Omar-Amaraa/Solar-Irradiance-Thermal-Sensor/data/plots/tensions_vs_temps.png

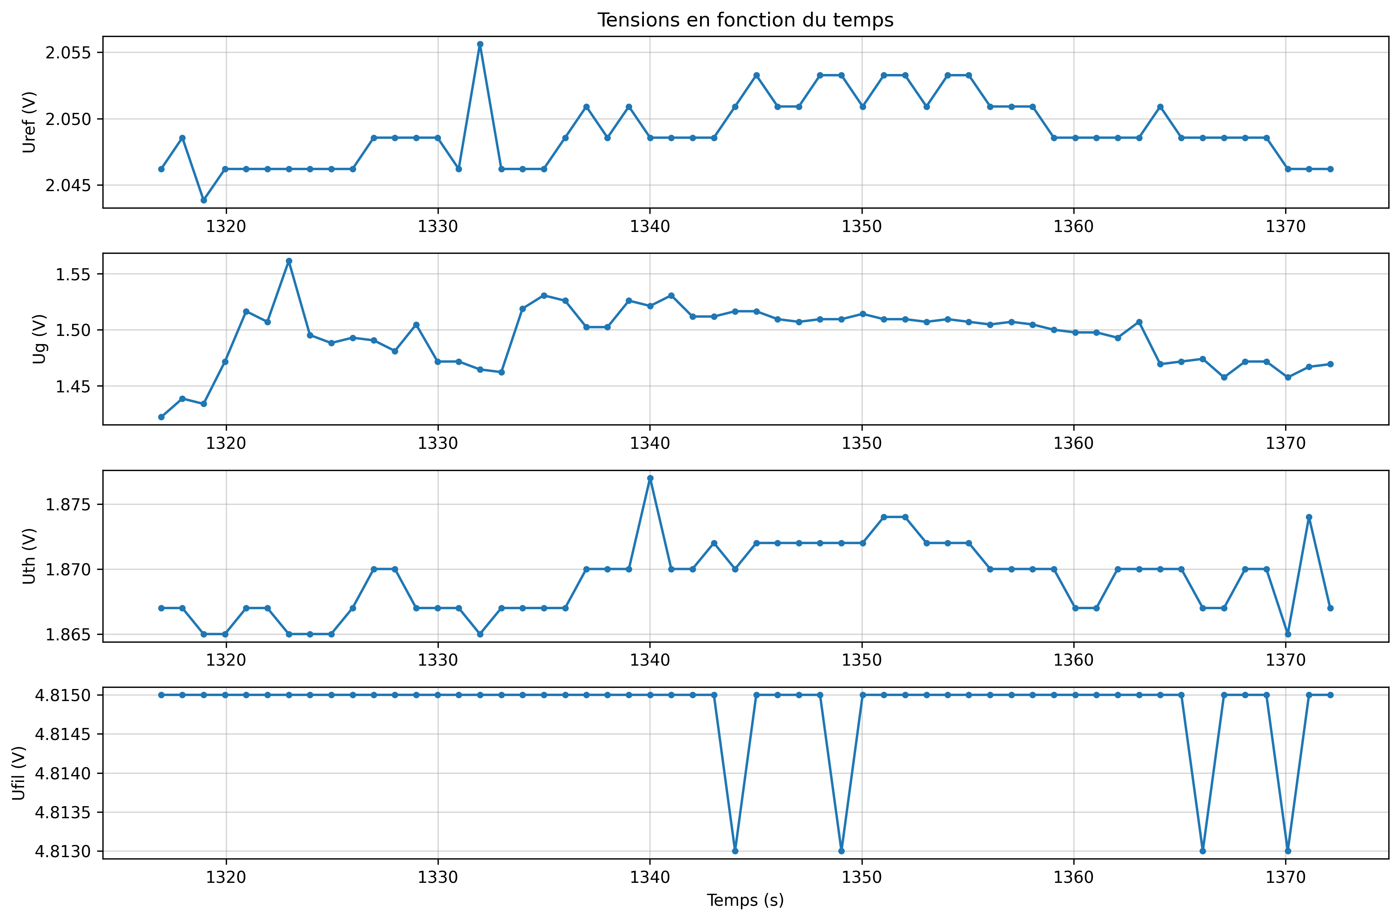
data/plots/tensions_vs_temps.png
