Omar-Amaraa/Solar-Irradiance-Thermal-Sensor/data/plots/Ug_vs_Uref_gain.png

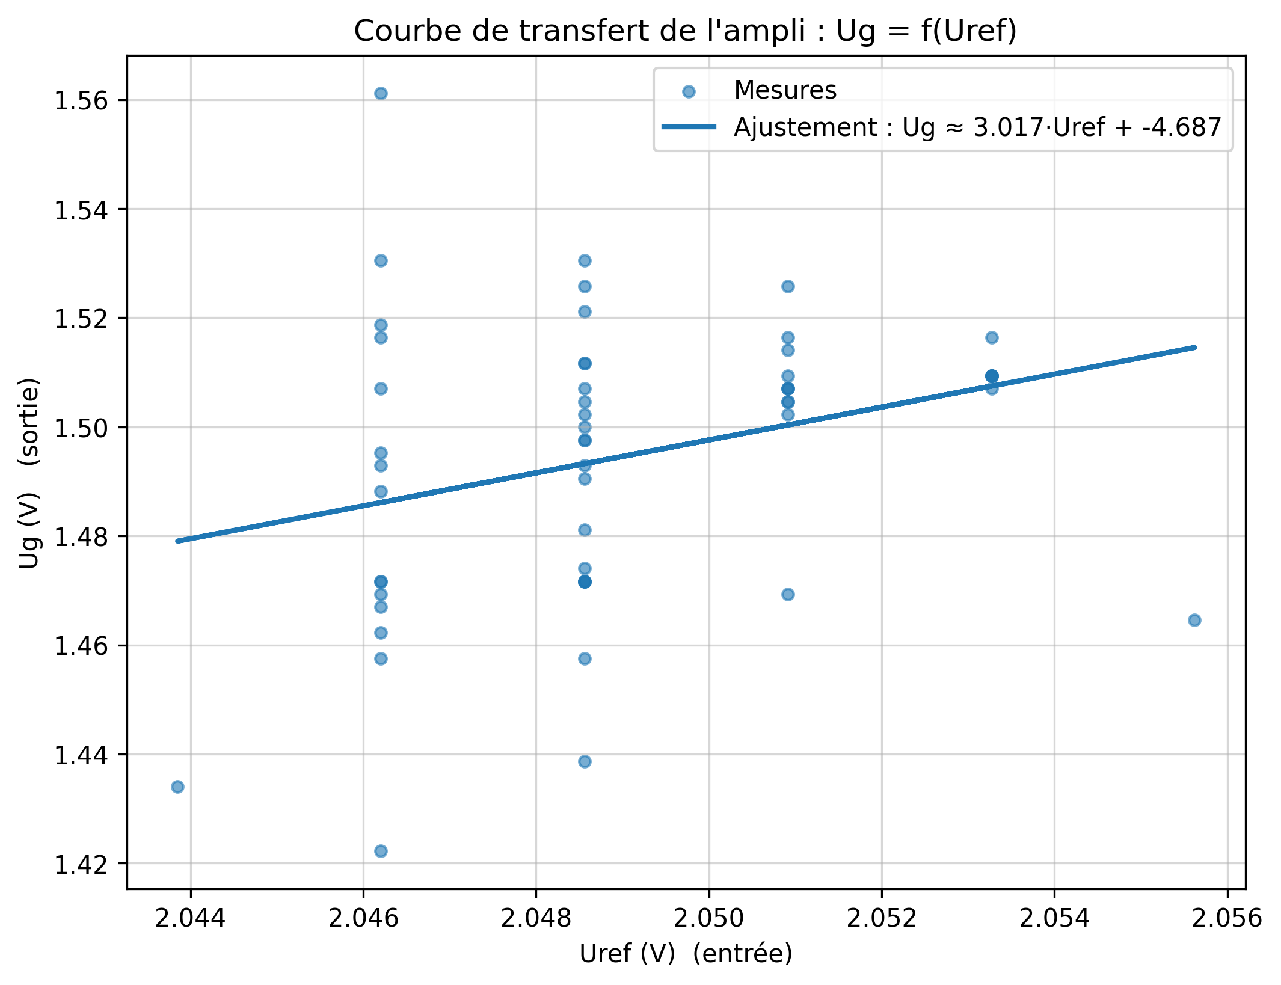
data/plots/Ug_vs_Uref_gain.png
