Omar-Amaraa/Solar-Irradiance-Thermal-Sensor/data/plots/Uth_Ufil_vs_temps.png

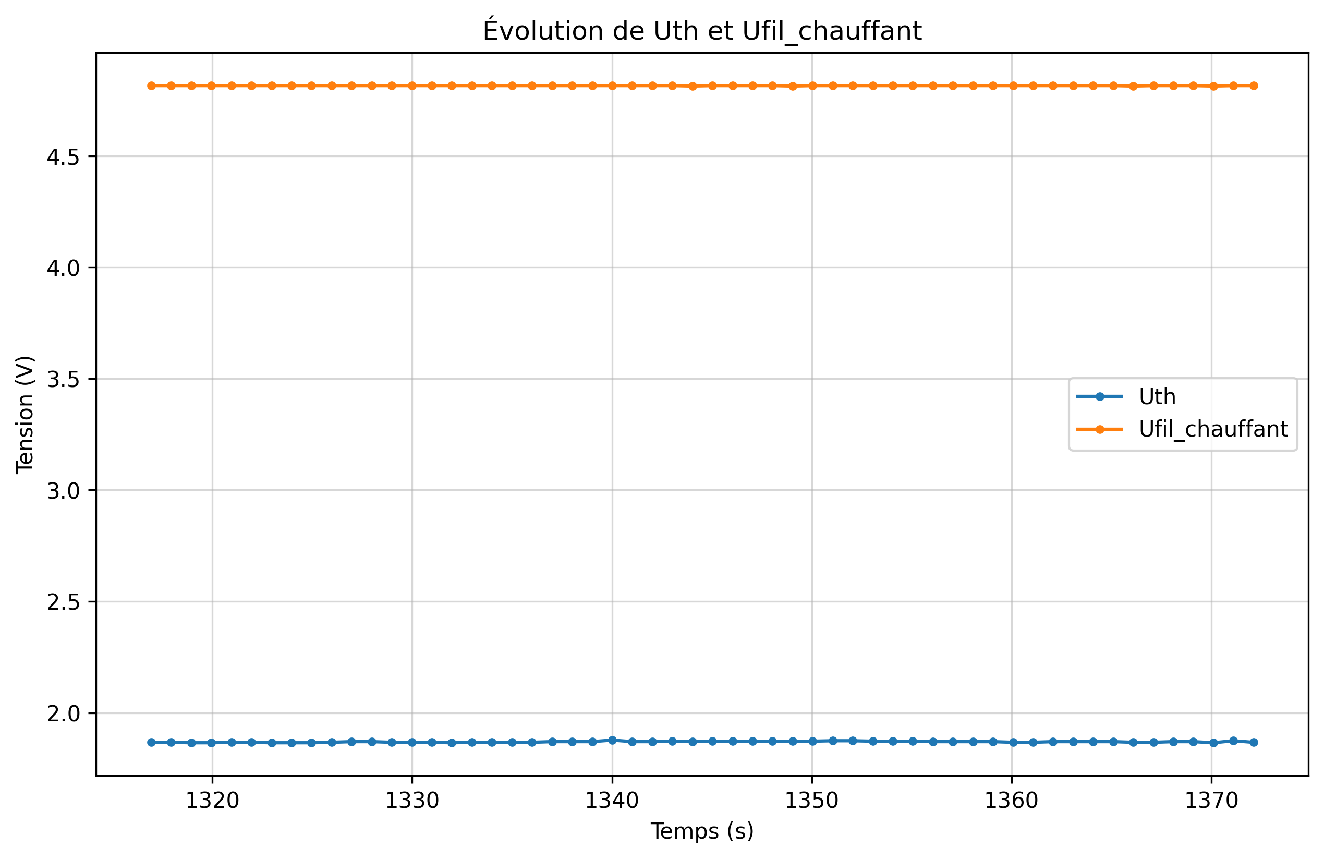
data/plots/Uth_Ufil_vs_temps.png
