Omar-Amaraa/Solar-Irradiance-Thermal-Sensor/data/01_voltage_divider_test/mesures.csv

temps: 316428 | Voltage: 1.92477
temps: 316660 | Voltage: 1.92233
temps: 316892 | Voltage: 1.92233
temps: 317124 | Voltage: 1.91988
temps: 317356 | Voltage: 1.91988
temps: 317588 | Voltage: 1.91988
temps: 317820 | Voltage: 1.91988
temps: 318052 | Voltage: 1.91500
temps: 318284 | Voltage: 1.90767
temps: 318516 | Voltage: 1.87347
temps: 318748 | Voltage: 1.90034
temps: 318980 | Voltage: 1.90034
temps: 319212 | Voltage: 1.90767
temps: 319444 | Voltage: 1.91011
temps: 319676 | Voltage: 1.91988
temps: 319908 | Voltage: 1.91988
temps: 320140 | Voltage: 1.91988
temps: 320372 | Voltage: 1.91744
temps: 320604 | Voltage: 1.91988
temps: 320836 | Voltage: 1.92233
temps: 321068 | Voltage: 1.92233
temps: 321300 | Voltage: 1.92477
temps: 321532 | Voltage: 1.92721
temps: 321764 | Voltage: 1.92721
temps: 321996 | Voltage: 1.93210
temps: 322228 | Voltage: 1.93210
temps: 322460 | Voltage: 1.93454
temps: 322692 | Voltage: 1.93454
temps: 322924 | Voltage: 1.93698
temps: 323156 | Voltage: 1.93942
temps: 323388 | Voltage: 1.93942
temps: 323620 | Voltage: 1.93942
temps: 323852 | Voltage: 1.93942
temps: 324084 | Voltage: 1.93942
temps: 324316 | Voltage: 1.94187
temps: 324548 | Voltage: 1.94187
temps: 324780 | Voltage: 1.94187
temps: 325012 | Voltage: 1.94187
temps: 325244 | Voltage: 1.94187
temps: 325476 | Voltage: 1.94187
temps: 325708 | Voltage: 1.94187
temps: 325940 | Voltage: 1.94187
temps: 326172 | Voltage: 1.93698
temps: 326404 | Voltage: 1.93454
temps: 326636 | Voltage: 1.93210
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
temps: 433356 | Voltage: 1.91011
temps: 433588 | Voltage: 1.90767
temps: 433820 | Voltage: 1.90523
temps: 434052 | Voltage: 1.91011
temps: 434284 | Voltage: 1.90523
temps: 434516 | Voltage: 1.90523
temps: 434748 | Voltage: 1.91011
temps: 434980 | Voltage: 1.91011
temps: 435212 | Voltage: 1.91500
