Omar-Amaraa/Solar-Irradiance-Thermal-Sensor/data/02_calibration/mesures0.csv

Ug | Ul | Temperature TMP | Temps
3.64738 | 1.56585 | 21.91 | 317
3.62618 | 1.57056 | 21.84 | 318
3.90404 | 1.49992 | 21.74 | 319
3.91345 | 1.48815 | 21.66 | 320
3.91581 | 1.49992 | 21.55 | 321
3.85694 | 1.51640 | 21.47 | 322
3.81220 | 1.52111 | 21.37 | 323
3.60264 | 1.55408 | 21.25 | 324
3.58851 | 1.55879 | 21.12 | 325
3.68741 | 1.53760 | 20.99 | 326
3.65915 | 1.54937 | 20.84 | 327
3.62148 | 1.55643 | 20.73 | 328
3.58851 | 1.56114 | 20.56 | 329
3.54377 | 1.57056 | 20.39 | 330
3.50845 | 1.57763 | 20.22 | 331
3.46607 | 1.58469 | 20.09 | 332
3.41426 | 1.59411 | 19.92 | 333
3.38130 | 1.60117 | 19.74 | 334
3.32008 | 1.61295 | 19.62 | 335
3.29418 | 1.61766 | 19.44 | 336
3.26828 | 1.62472 | 19.27 | 337
3.24002 | 1.62707 | 19.13 | 338
3.20235 | 1.63649 | 18.95 | 339
3.16467 | 1.64356 | 18.83 | 340
3.11758 | 1.65298 | 18.69 | 341
3.07990 | 1.66239 | 18.52 | 342
3.03987 | 1.66710 | 18.37 | 343
3.01633 | 1.67181 | 18.24 | 344
2.99042 | 1.67888 | 18.12 | 345
2.96452 | 1.68359 | 17.97 | 346
2.93156 | 1.69065 | 17.78 | 347
2.91508 | 1.69300 | 17.64 | 348
2.88682 | 1.69771 | 17.51 | 349
2.86327 | 1.70242 | 17.35 | 350
2.84208 | 1.70713 | 17.22 | 351
2.82324 | 1.70949 | 17.06 | 352
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
