Omar-Amaraa/Solar-Irradiance-Thermal-Sensor/data/02_calibration/mesures4.csv

Ug | Ul | Temperature TMP | Temps
2.83502 | 1.75658 | 16.68 | 11
2.83031 | 1.75894 | 16.59 | 12
2.81853 | 1.76129 | 16.52 | 13
2.80205 | 1.76835 | 16.44 | 14
2.79734 | 1.76364 | 16.36 | 15
2.78792 | 1.76600 | 16.29 | 16
2.78086 | 1.76835 | 16.22 | 17
2.76673 | 1.77071 | 16.14 | 18
2.76202 | 1.77071 | 16.08 | 19
2.75496 | 1.77071 | 16.01 | 20
2.74554 | 1.77306 | 15.94 | 21
2.74083 | 1.77306 | 15.88 | 22
2.74083 | 1.77777 | 15.80 | 23
2.72199 | 1.78013 | 15.74 | 24
2.71964 | 1.77777 | 15.67 | 25
2.70787 | 1.78013 | 15.61 | 26
2.70316 | 1.78013 | 15.55 | 27
2.69374 | 1.78484 | 15.48 | 28
2.68196 | 1.78719 | 15.42 | 29
2.67961 | 1.78719 | 15.36 | 30
2.66548 | 1.78955 | 15.30 | 31
2.66077 | 1.78955 | 15.24 | 32
2.65371 | 1.79190 | 15.19 | 33
2.64664 | 1.79426 | 15.13 | 34
2.63723 | 1.79190 | 15.07 | 35
2.63252 | 1.79426 | 15.01 | 36
2.62545 | 1.79661 | 14.95 | 37
2.61839 | 1.79896 | 14.89 | 38
2.61839 | 1.79896 | 14.84 | 39
2.60897 | 1.79896 | 14.79 | 40
2.60426 | 1.79896 | 14.73 | 41
2.59484 | 1.80367 | 14.69 | 42
2.59249 | 1.80367 | 14.63 | 43
2.58542 | 1.80367 | 14.59 | 44
2.58307 | 1.80367 | 14.54 | 45
2.57365 | 1.80603 | 14.49 | 46
2.57129 | 1.80838 | 14.45 | 47
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
