Omar-Amaraa/Solar-Irradiance-Thermal-Sensor/data/02_calibration/mesures6.csv

Ug | Ul | Uref | Temperature TMP | Temps
0.83591 | 1.93553 | 0.00000 | 13.54 | 25
0.82649 | 1.93789 | 0.00000 | 13.45 | 26
0.81236 | 1.94024 | 0.00000 | 13.34 | 27
0.79352 | 1.94495 | 0.00000 | 13.21 | 28
0.77939 | 1.94731 | 0.00000 | 13.09 | 29
0.76762 | 1.94966 | 0.00000 | 12.98 | 30
0.75114 | 1.95437 | 0.00000 | 12.86 | 31
0.73701 | 1.95673 | 0.00000 | 12.75 | 32
0.72759 | 1.95673 | 0.00000 | 12.66 | 33
0.71346 | 1.96144 | 0.00000 | 12.56 | 34
0.69934 | 1.96379 | 0.00000 | 12.45 | 35
0.68756 | 1.96850 | 0.00000 | 12.34 | 36
0.68050 | 1.96850 | 0.00000 | 12.27 | 37
0.66872 | 1.97085 | 0.00000 | 12.19 | 38
0.65695 | 1.97321 | 0.00000 | 12.08 | 39
0.64753 | 1.97556 | 0.00000 | 11.99 | 40
0.63811 | 1.97792 | 0.00000 | 11.89 | 41
0.62399 | 1.98027 | 0.00000 | 11.80 | 42
0.61457 | 1.98263 | 0.00000 | 11.69 | 43
0.60279 | 1.98498 | 0.00000 | 11.60 | 44
0.59573 | 1.98498 | 0.00000 | 11.52 | 45
0.60279 | 1.97792 | 0.00000 | 11.52 | 46
0.60279 | 1.98498 | 0.00000 | 11.41 | 47
0.59102 | 1.98498 | 0.00000 | 11.34 | 48
0.57689 | 1.99911 | 0.00000 | 11.24 | 49
0.57925 | 1.98969 | 0.00000 | 11.14 | 50
0.57454 | 1.98969 | 0.00000 | 11.10 | 51
0.56747 | 1.98498 | 0.00000 | 11.05 | 52
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
