Omar-Amaraa/Solar-Irradiance-Thermal-Sensor/code/fr/python/enregistrement_etalonnage.py

import serial
import csv
import matplotlib.pyplot as plt
Ug=[]
Temperature=[]
Temps=[]
Ul=[]
Uref=[]
i=10
port = "COM5"          # port sur lequel est branché l'arduino
baudrate = 115200        # Même que Serial.begin(9600)

#ouverture du port serie (merci chatgpt)
ser = serial.Serial(port, baudrate)
data =['Ug','Ul','Uref','Temperature TMP','Temps']
# Ouvre le fichier CSV en écriture
with open("mesures"+str(i)+".csv", "w", newline="") as csvfile:
    writer = csv.writer(csvfile)
    writer.writerow(data)
    print("Enregistrement des données... (Ctrl+C pour arrêter)")

    try:
        while True:
            # Lire une ligne depuis Arduino
            ligne = ser.readline().decode("utf-8").strip()
            print(ligne)  # affichage pour debug

            # Sauvegarder dans le CSV
            writer.writerow(ligne.split(","))
    except KeyboardInterrupt:
        print("Arrêt de l'enregistrement.")
        i+=1
    
with open("mesures"+str(i-1)+".csv", "r") as csvfile:
    reader = csv.reader(csvfile)
    next(reader)  # saute la première ligne (en-tête)
    for row in reader:
        try:
            Ug.append(float(row[0]))       # 1ère colonne
            Ul.append(float(row[1]))    # 2ème colonne
            Uref.append(float(row[2]))    # 3ème colonne
            Temperature.append(float(row[3]))  # 4ème colonne
            Temps.append(float(row[4]))        # 5ème colonne
        except (ValueError, IndexError):
            # ignore les lignes vides ou incorrectes
            pass

plt.figure(figsize=(12, 9))

#  Ug vs Temps
plt.subplot(3, 1, 1)
plt.plot(Temps, Ug, color='royalblue', marker='o', markersize=4, linestyle='-')
plt.title("Évolution de Ug dans le temps", fontsize=14)
plt.xlabel("Temps (s)")
plt.ylabel("Ug (V)")
plt.grid(True, alpha=0.5)

#  Température vs Temps
plt.subplot(3, 1, 2)
plt.plot(Temps, Temperature, color='crimson', marker='s', markersize=4, linestyle='-')
plt.title("Évolution de la Température dans le temps", fontsize=14)
plt.xlabel("Temps (s)")
plt.ylabel("Température (°C)")
plt.grid(True, alpha=0.5)

#  Ug vs Température (nuage de points + ligne de tendance)
import numpy as np
plt.subplot(3, 1, 3)
plt.scatter(Temperature, Ug, color='green', s=50, alpha=0.2, label='Mesures')
# Ajustement linéaire
if len(Temperature) > 1:
    m, b = np.polyfit(Temperature, Ug, 1)
    plt.plot(Temperature, m*np.array(Temperature)+b, color='orange', label=f'Fit : y={m:.3f}x+{b:.3f}')
plt.title("Relation entre Ug et la Température", fontsize=14)
plt.xlabel("Température (°C)")
plt.ylabel("Ug (V)")
plt.grid(True, alpha=0.5)
plt.legend()

plt.tight_layout()
plt.show()
