Omar-Amaraa/Solar-Irradiance-Thermal-Sensor/(commit log)

2025-09-21 Enregistrement/ lecture des valeurs de tensions
    faites tournez le fichier python ou le fichier arduino ( !!!! pas les deux en mm temps sinon ça crée un conflit à la lecture )
    [mesures.csv]
2025-09-28 Lecture de tension et mesures de température
    Thermometre rouge et la thermistance
2025-10-14 lecture de tension avec le pont diviseur
    on avait des erreurs dans la formule
2025-10-24 nouvelle version !!!!
    enregistrement des valeurs et affichage ( attention j'ai pas mis dans la liste de enregistrement.py les Uref, comme on a pas pu lire ca la derniere fois) cepandant, c'est pris dans le fichier etalonnage.ino qui lui l'affiche sur le Serial Monitor
    [mesures0.csv, mesures4.csv]
2025-11-24 on stocke toutes les valeurs + affichage stylé
    [mesures10.csv]
2026-10-04 Restructure repo: FR/EN code, data folder, reports, English README
    - code/fr: original sketches and scripts (merge conflict in enregistrement.py resolved,
    Uref bug in etalonnage.ino fixed, trace_csv.py made runnable)
    - code/en: English translation of all code
    - data/: all measurement CSVs + plots, with a data README (adds mesures6.csv)
    - docs/: final reports (EN/FR) and photos/figures
    - README rewritten in English: circuit, calibration, CT, solar results
    [mesures.csv, mesures0.csv, mesures10.csv, mesures4.csv, mesures6.csv]
